lucarib1/Projeto-TCC/Fotos do projeto/20260927_133529.jpg

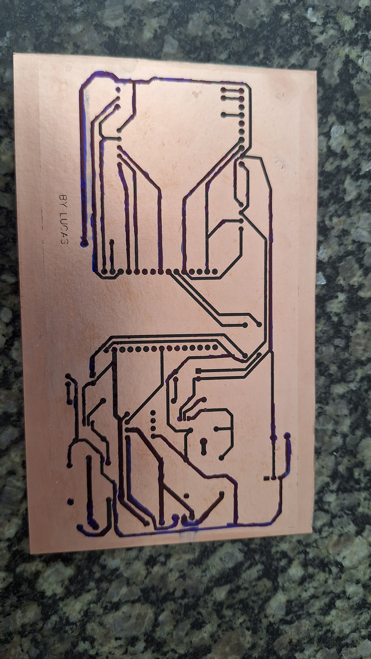
Fotos do projeto/20260927_133529.jpg
