lucarib1/Projeto-TCC/Circuito eletrico/Modelo 3D .png

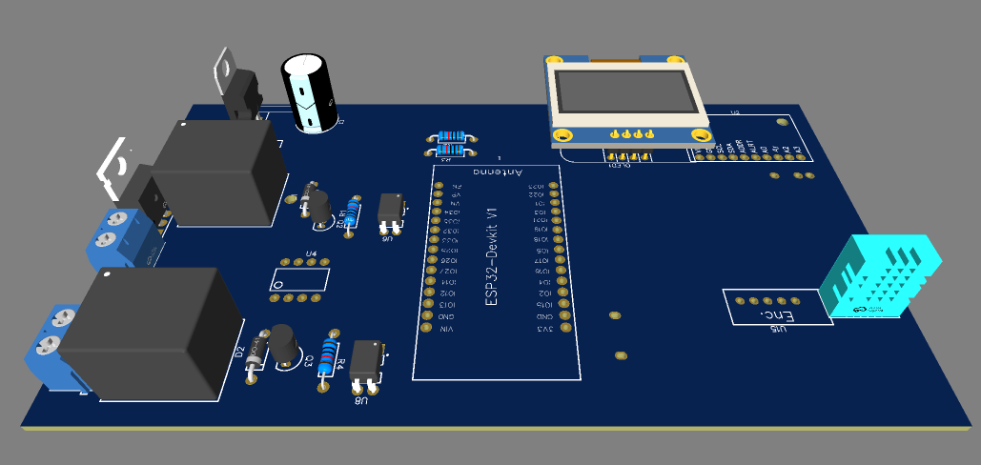
Circuito eletrico/Modelo 3D .png
