lucarib1/Projeto-TCC/Codigo/Fluxograma.png

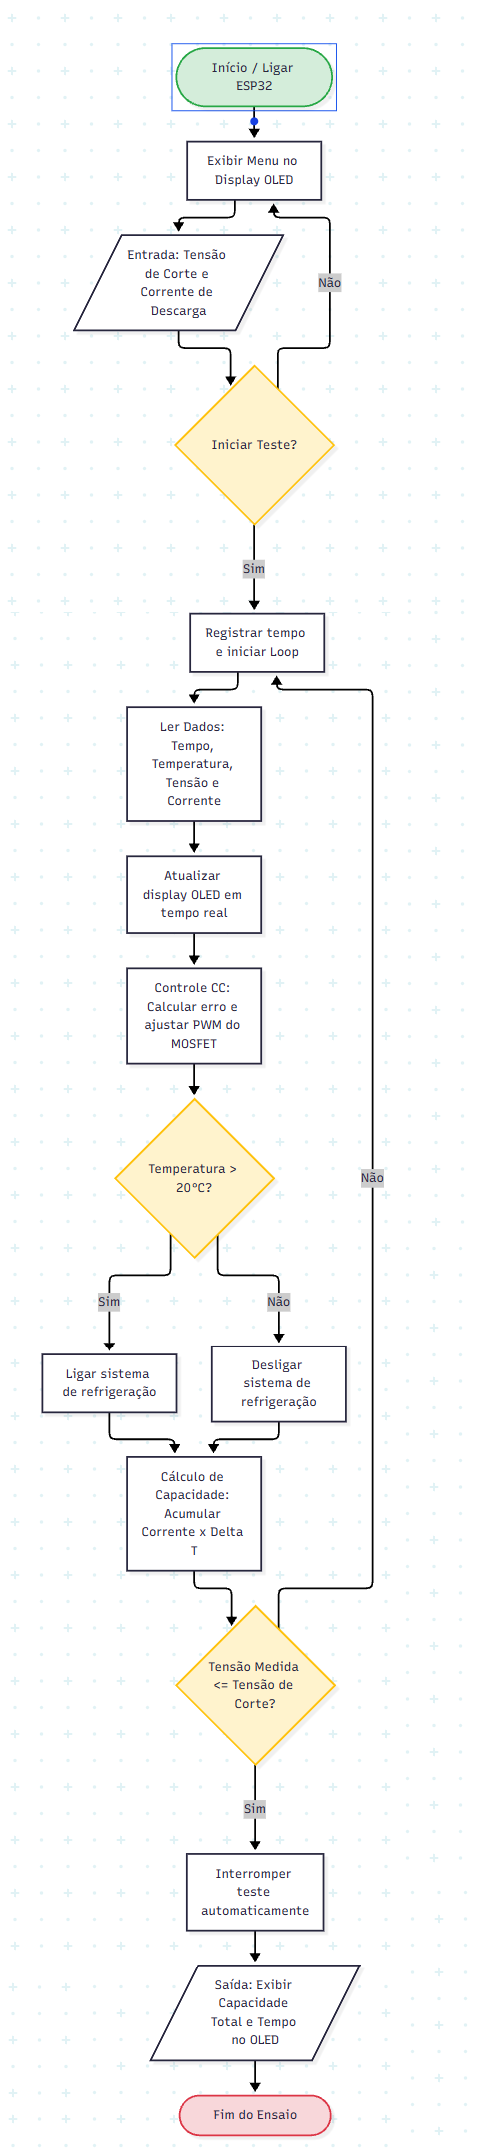
Codigo/Fluxograma.png
