lucarib1/Projeto-TCC/Fotos do projeto/20261005_211815.jpg

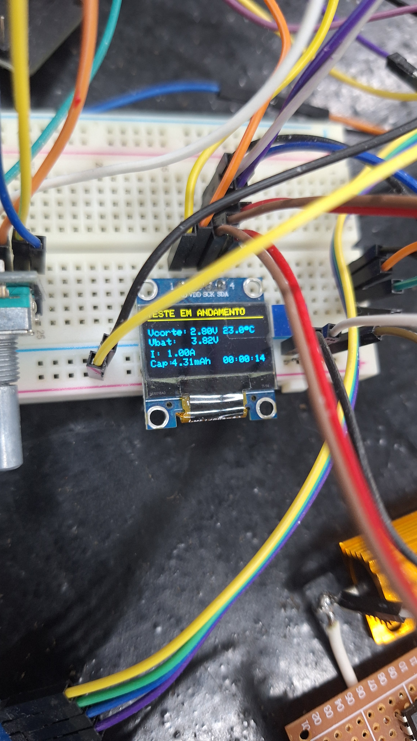
Fotos do projeto/20261005_211815.jpg
