lucarib1/Projeto-TCC/Fotos do projeto/20261012_152716.jpg

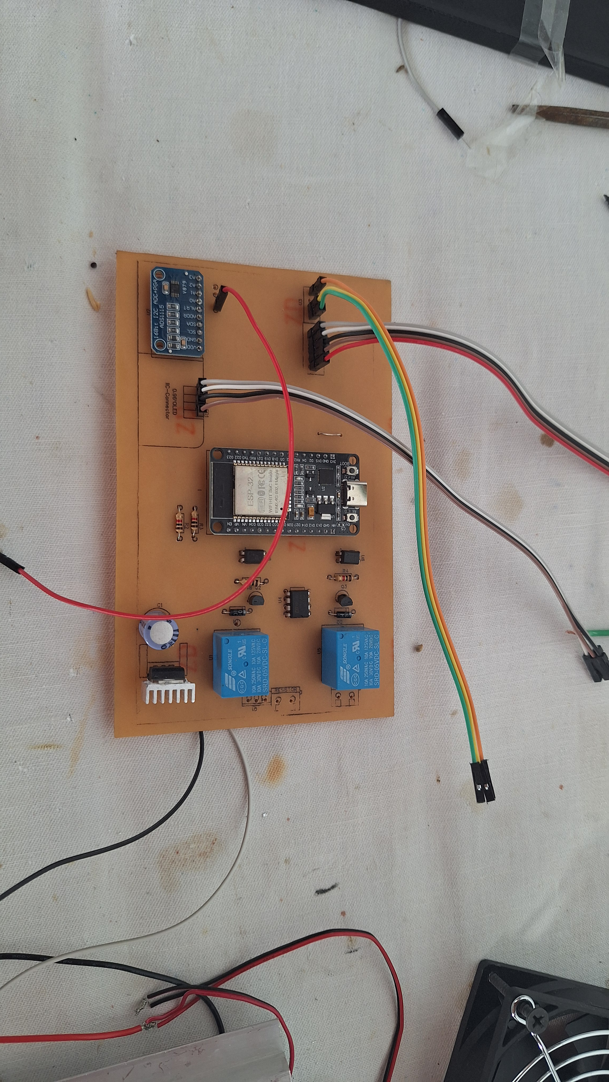
Fotos do projeto/20261012_152716.jpg
