lucarib1/Projeto-TCC/Fotos do projeto/20261018_150427.jpg

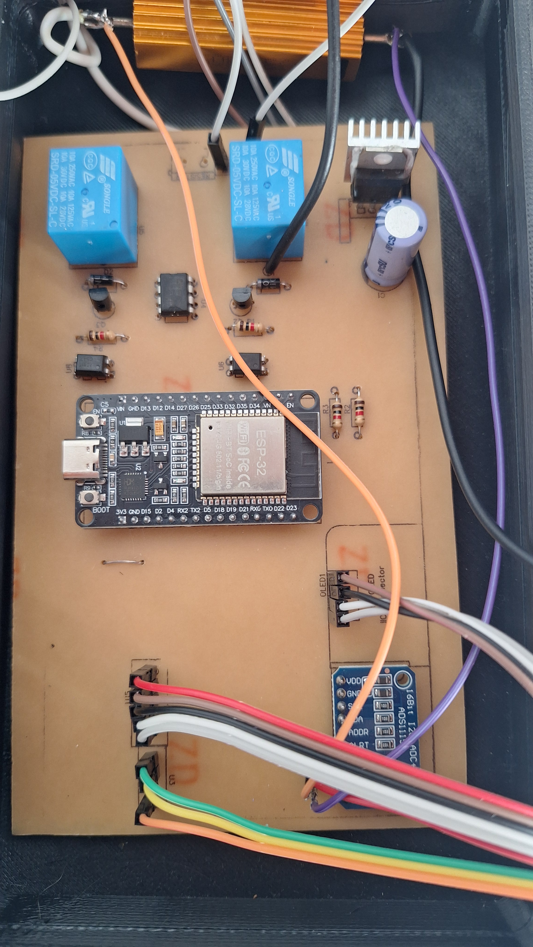
Fotos do projeto/20261018_150427.jpg
