lucarib1/Projeto-TCC/Circuito eletrico/Diagrama do circuito_TCC_2026-10-30.pdf

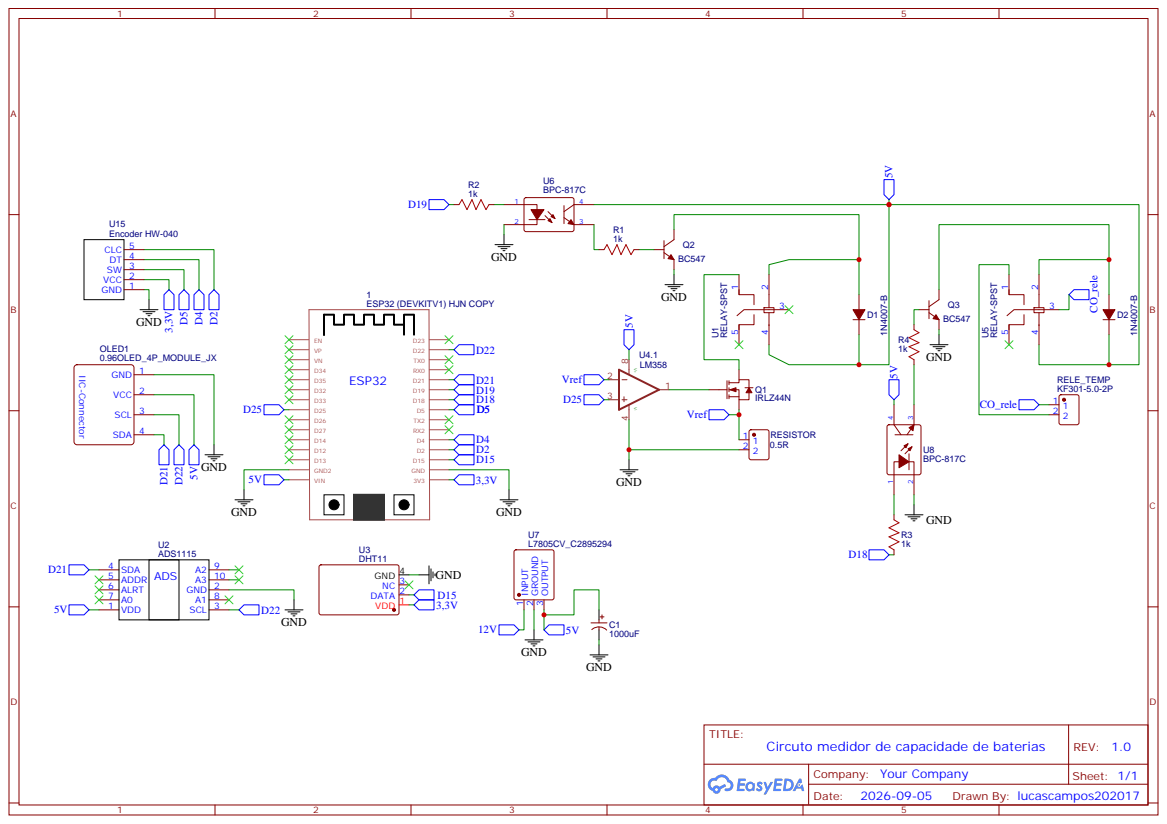
[picture p8: page 1]
