lucarib1/Projeto-TCC/Circuito eletrico/PCB_PCB_TCC_2026-09-20 (3).pdf

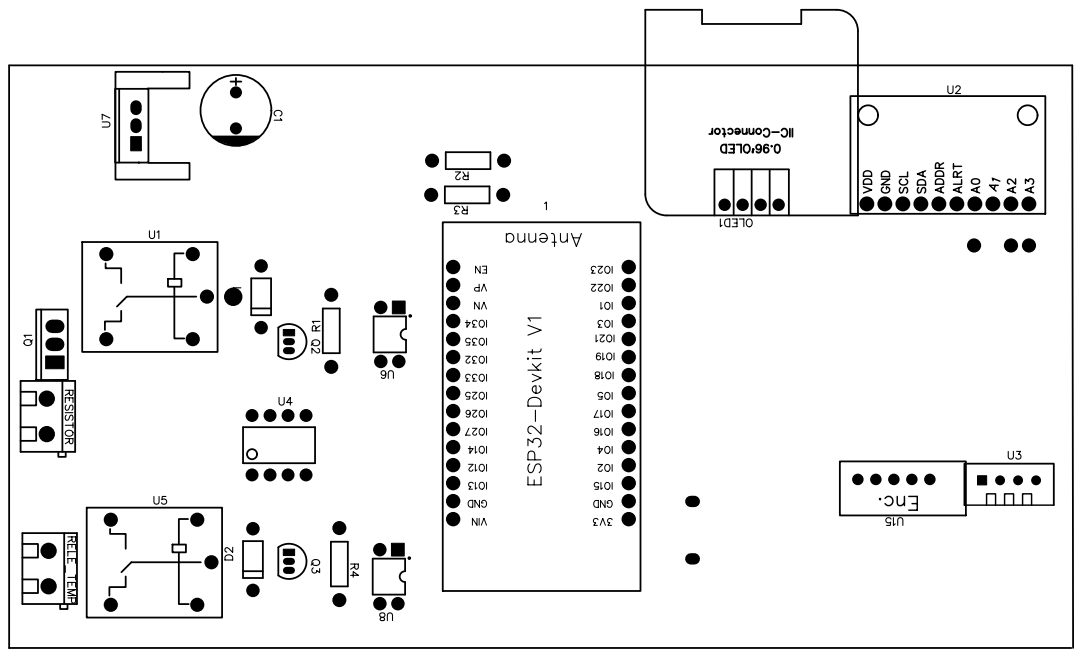
[picture p9: page 1]
