lucarib1/Projeto-TCC/Simulações/Circuito_Corrente_Maxima_Teorica.asc

R1: res; 0.5
V1: voltage; 4.2
Named nets: V_carga, 0
.tran 5m
