lucarib1/Projeto-TCC/Fotos do projeto/20261005_214328.jpg

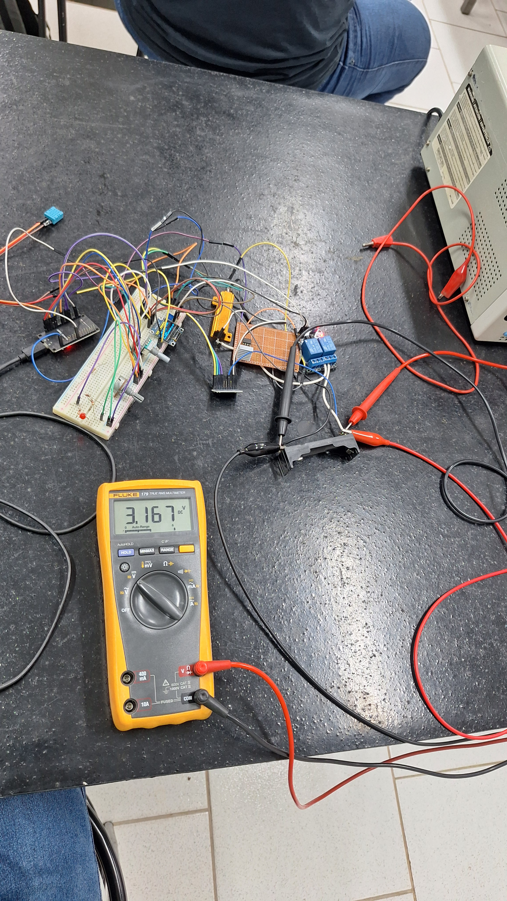
Fotos do projeto/20261005_214328.jpg
